quizque/Capstone/stargazer/stargazer.step

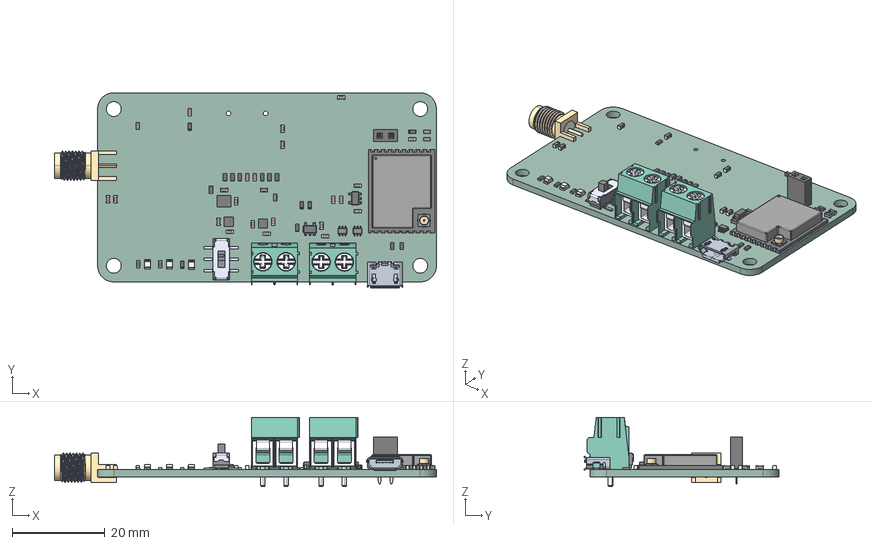
[picture p1: CAD file, 2024-07-02]
stargazer/stargazer.step
82.3 x 42.1 x 14.9 mm
ESP32-C3-WROOM-02U
R_0603_1608Metric x 17
C_0603_1608Metric x 27
JS202011SCQN
LGA_12_2x2mm_P05mm x 2
SOT_23_5 x 2
LGA_14_3x25mm_P05mm_LayoutBorder3x4y
DCK0006A_ASM x 2
PinSocket_1x02_P254mm_Vertical
CON-SMA-EDGE-S
LED_0805_2012Metric x 3
10118193-0001LF
stargazer_PCB
