quizque/Capstone/tools/data_vis/rocket.obj

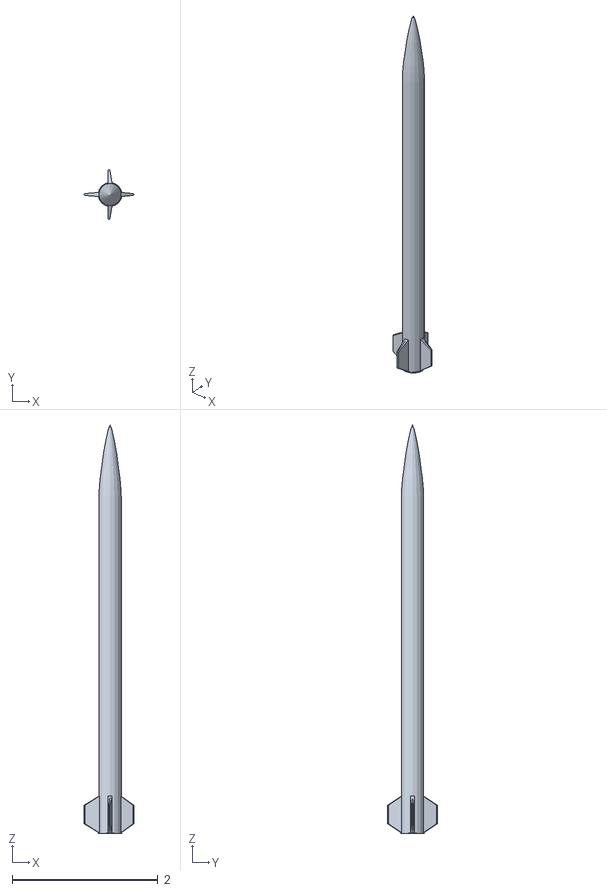
[picture p2: CAD file, 2024-07-23]
tools/data_vis/rocket.obj
0.689 x 0.689 x 5.61
