quizque/Capstone/sensor-testing/attenuation.xlsx

Noise Floor | -80
Nothing | -55
Steel Cube | -60
Aluminum | -65
Carbon | -60
