quizque/Capstone/sensor-testing/Pressure sensor data.xlsx

time | LPS25HBTR | LPS25HBTR (n) | LPS25HBTR (n,f) | time | BMP280 | BMP280 (n) | BMP280 (n,f) | time | MS8607 | BMP390 | MS8607(n) | BMP390 (n) | MS8607(n,f) | BMP390 (n,f)
5.7e-05 | 997.041 | 0.589440277 |  | 0.000973 | 990.4519 | 0.6601269475
0.044008 | 997.1052 | 0.7746682054 |  | 0.043924 | 990.4841 | 0.7530294287 |  | 3.374843 | 991.01001 | 990.442934 | 0.439944 | 1
0.087608 | 997.0659 | 0.6612810156 | 0.6716676284 | 0.08653801 | 990.4389 | 0.6226197346 | 0.6645989613 | 3.458227 | 991.059998 | 990.362652 | 0.639896 | 0.7693867702 | 0.429934 | 0.6346933851
0.131169 | 997.1001 | 0.7599538373 | 0.7389642239 | 0.129095 | 990.4712 | 0.7158107328 | 0.7018176572 | 3.541538 | 991.080017 | 990.317891 | 0.719972 | 0.6408090221 | 0.629946 | 0.7627512036 | STDEV.s
0.17461 | 997.1023 | 0.7663012118 | 0.7384593191 | 0.171532 | 990.4519 | 0.6601269475 | 0.6646710906 | 3.624839 | 991.070007 | 990.297183 | 0.679932 | 0.5813244706 | 0.679933 | 0.6432111834
0.218063 | 997.0972 | 0.7515868436 | 0.7573571841 | 0.213937 | 990.448 | 0.6488747836 | 0.6684218119 | 3.708136 | 991.090027 | 990.291094 | 0.760012 | 0.5638335765 | 0.729982 | 0.5874501614 | LPS25HBTR
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
