quizque/Capstone/stargazer/stargazer.kicad_pcb

## KiCad design stargazer/stargazer.kicad_pcb (2024-07-26)

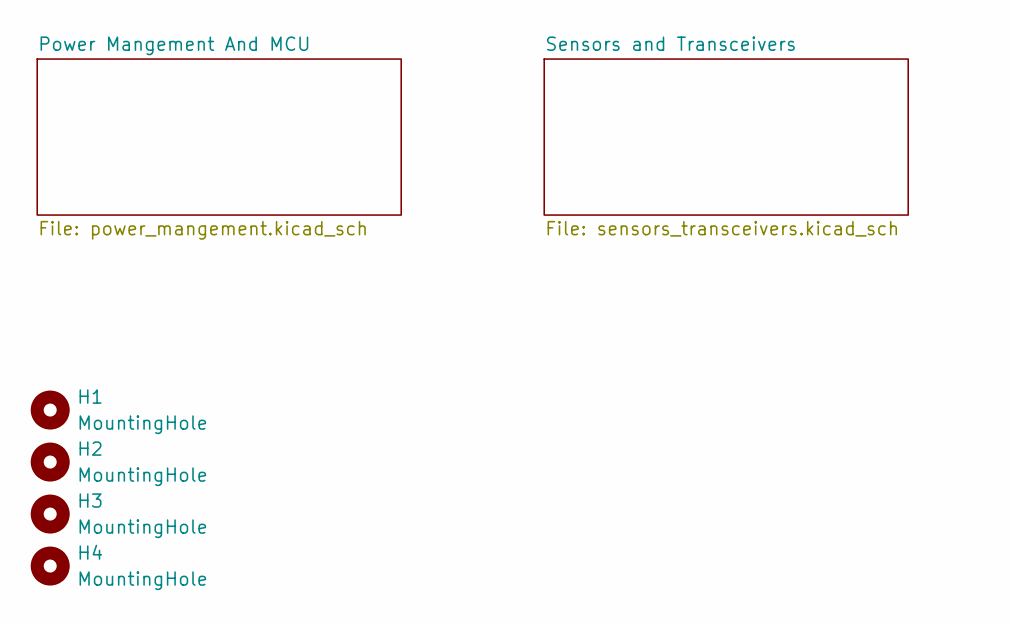
[picture p3: schematic stargazer.kicad_sch]

Parts:
H1, H2, H3, H4: MountingHole; MountingHole_3.2mm_M3_DIN965_Pad

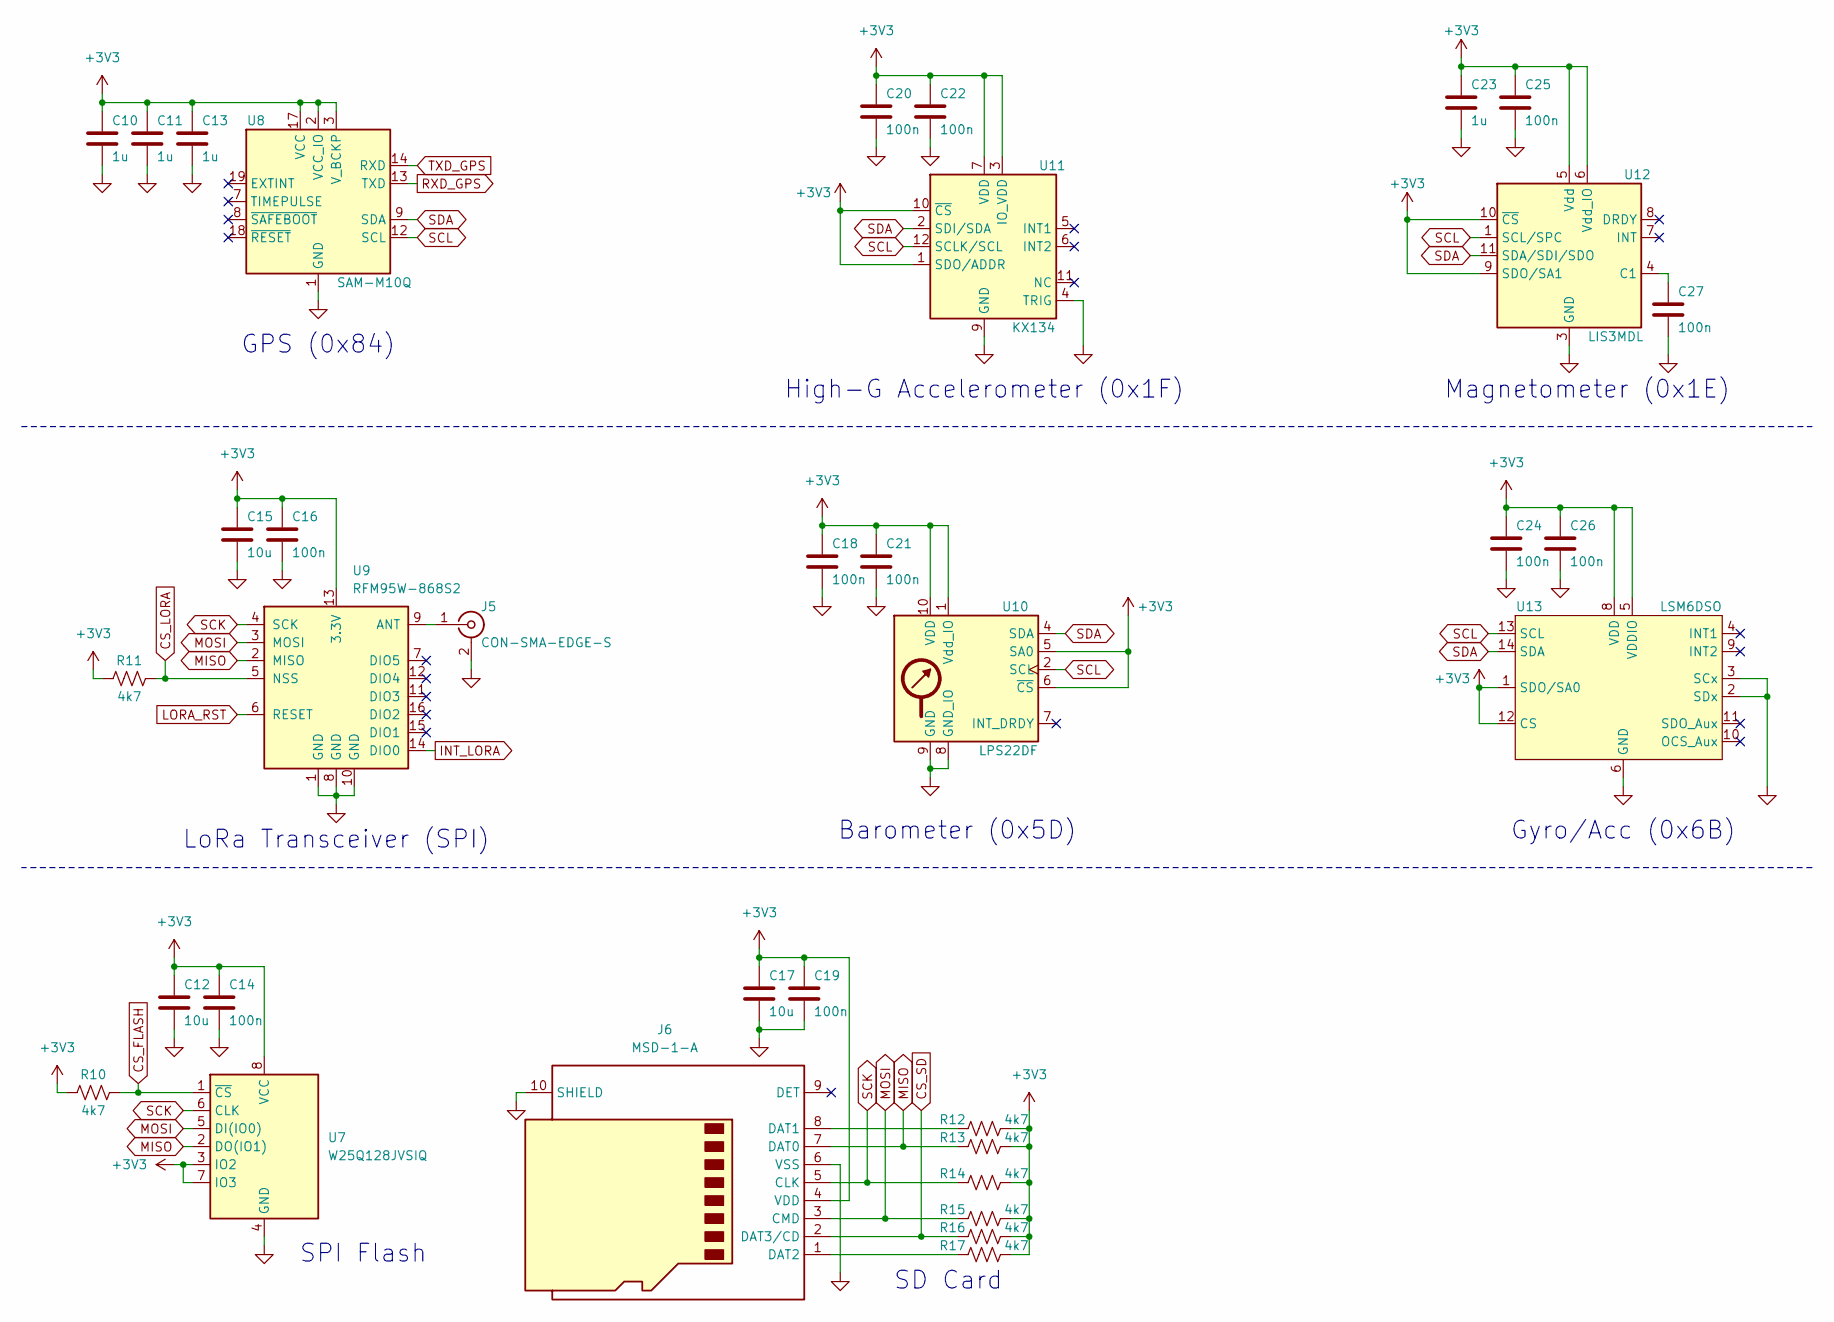
[picture p4: schematic sensors_transceivers.kicad_sch, Sensors & Data ICs]

Parts:
C10, C11, C13, C23: 1u; C_0603_1608Metric; digikeynumber CL10B105KP8NFNC
C12, C15, C17: 10u; C_0603_1608Metric; digikeynumber CL10A106KQ8NNNC
C14, C16, C18, C19, C20, C21, C22, C24, C25, C26, C27: 100n; C_0603_1608Metric; digikeynumber CL10B104KO8NNWC
J5: CON-SMA-EDGE-S; RFSOLUTIONS_CON-SMA-EDGE-S; digikeynumber CON-SMA-EDGE-S
J6: MSD-1-A; CONN9_MSD-1_CUD; digikeynumber MSD-1-A
R10, R11, R12, R13, R14, R15, R16, R17: 4k7; R_0603_1608Metric; digikeynumber RC0603FR-074K7L
U7: W25Q128JVSIQ; SOIC-8_5.23x5.23mm_P1.27mm; digikeynumber W25Q128JVSIQ
U8: SAM-M10Q; ublox_SAM-M10Q; digikeynumber SAM-M10Q-00B
U9: RFM95W-868S2; HOPERF_RFM9XW_SMD
U10: LPS22DF; ST_HLGA-10_2x2mm_P0.5mm_LayoutBorder3x2y; digikeynumber LPS22DFTR
U11: KX134; LGA-12_2x2mm_P0.5mm; digikeynumber KX134-1211
U12: LIS3MDL; LGA-12_2x2mm_P0.5mm; digikeynumber LIS3MDLTR
U13: LSM6DSO; LGA-14_3x2.5mm_P0.5mm_LayoutBorder3x4y; digikeynumber LSM6DSOTR

Connections:
+3V3: C10.1, C11.1, C12.1, C13.1, C14.1, C15.1, C16.1, C17.1, C18.1, C19.1, C20.1, C21.1, C22.1, C23.1, C24.1, C25.1, C26.1, J6.4 (VDD), R10.1, R11.1, R12.2, R13.2, R14.2, R15.2, R16.2, R17.2, U7.3 (IO2), U7.7 (IO3), U7.8 (VCC), U8.2 (VCC_IO), U8.3 (V_BCKP), U8.17 (VCC), U9.13 (3.3V), U10.1 (Vdd_IO), U10.5 (SA0), U10.6 (~CS), U10.10 (VDD), U11.1 (SDO/ADDR), U11.3 (IO_VDD), U11.7 (VDD), U11.10 (~CS), U12.5 (Vdd), U12.6 (Vdd_IO), U12.9 (SDO/SA1), U12.10 (~CS), U13.1 (SDO/SA0), U13.5 (VDDIO), U13.8 (VDD), U13.12 (CS); also elsewhere on the board
CS_FLASH: R10.2, U7.1 (~CS); also elsewhere on the board
CS_LORA: R11.2, U9.5 (NSS); also elsewhere on the board
CS_SD: J6.2 (DAT3/CD), R16.1; also elsewhere on the board
GND: C10.2, C11.2, C12.2, C13.2, C14.2, C15.2, C16.2, C17.2, C18.2, C19.2, C20.2, C21.2, C22.2, C23.2, C24.2, C25.2, C26.2, C27.2, J5.2 (Ext), J6.6 (VSS), J6.10 (SHIELD), U7.4 (GND), U8.1 (GND), U8.4 (GND), U8.5 (GND), U8.6 (GND), U8.10 (GND), U8.11 (GND), U8.15 (GND), U8.16 (GND), U8.20 (GND), U9.1 (GND), U9.8 (GND), U9.10 (GND), U10.3 (GND), U10.8 (GND_IO), U10.9 (GND), U11.4 (TRIG), U11.8 (GND), U11.9 (GND), U12.2 (GND), U12.3 (GND), U12.12 (GND), U13.2 (SDx), U13.3 (SCx), U13.6 (GND), U13.7 (GND); also elsewhere on the board
INT_LORA: U9.14 (DIO0); also elsewhere on the board
LORA_RST: U9.6 (RESET); also elsewhere on the board
MISO: J6.7 (DAT0), R13.1, U7.2 (DO(IO1)), U9.2 (MISO); also elsewhere on the board
MOSI: J6.3 (CMD), R15.1, U7.5 (DI(IO0)), U9.3 (MOSI); also elsewhere on the board
unnamed: J5.1 (In), U9.9 (ANT)
unnamed: J6.8 (DAT1), R12.1
unnamed: J6.1 (DAT2), R17.1
unnamed: C27.1, U12.4 (C1)
RXD_GPS: U8.13 (TXD); also elsewhere on the board
SCK: J6.5 (CLK), R14.1, U7.6 (CLK), U9.4 (SCK); also elsewhere on the board
SCL: U8.12 (SCL), U10.2 (SCL), U11.12 (SCLK/SCL), U12.1 (SCL/SPC), U13.13 (SCL); also elsewhere on the board
SDA: U8.9 (SDA), U10.4 (SDA), U11.2 (SDI/SDA), U12.11 (SDA/SDI/SDO), U13.14 (SDA); also elsewhere on the board
TXD_GPS: U8.14 (RXD); also elsewhere on the board

Notes on the sheet:
Magnetometer (0x1E)
GPS (0x84)
High-G Accelerometer (0x1F)
SD Card
Gyro/Acc (0x6B)
LoRa Transceiver (SPI)
SPI Flash
Barometer (0x5D)

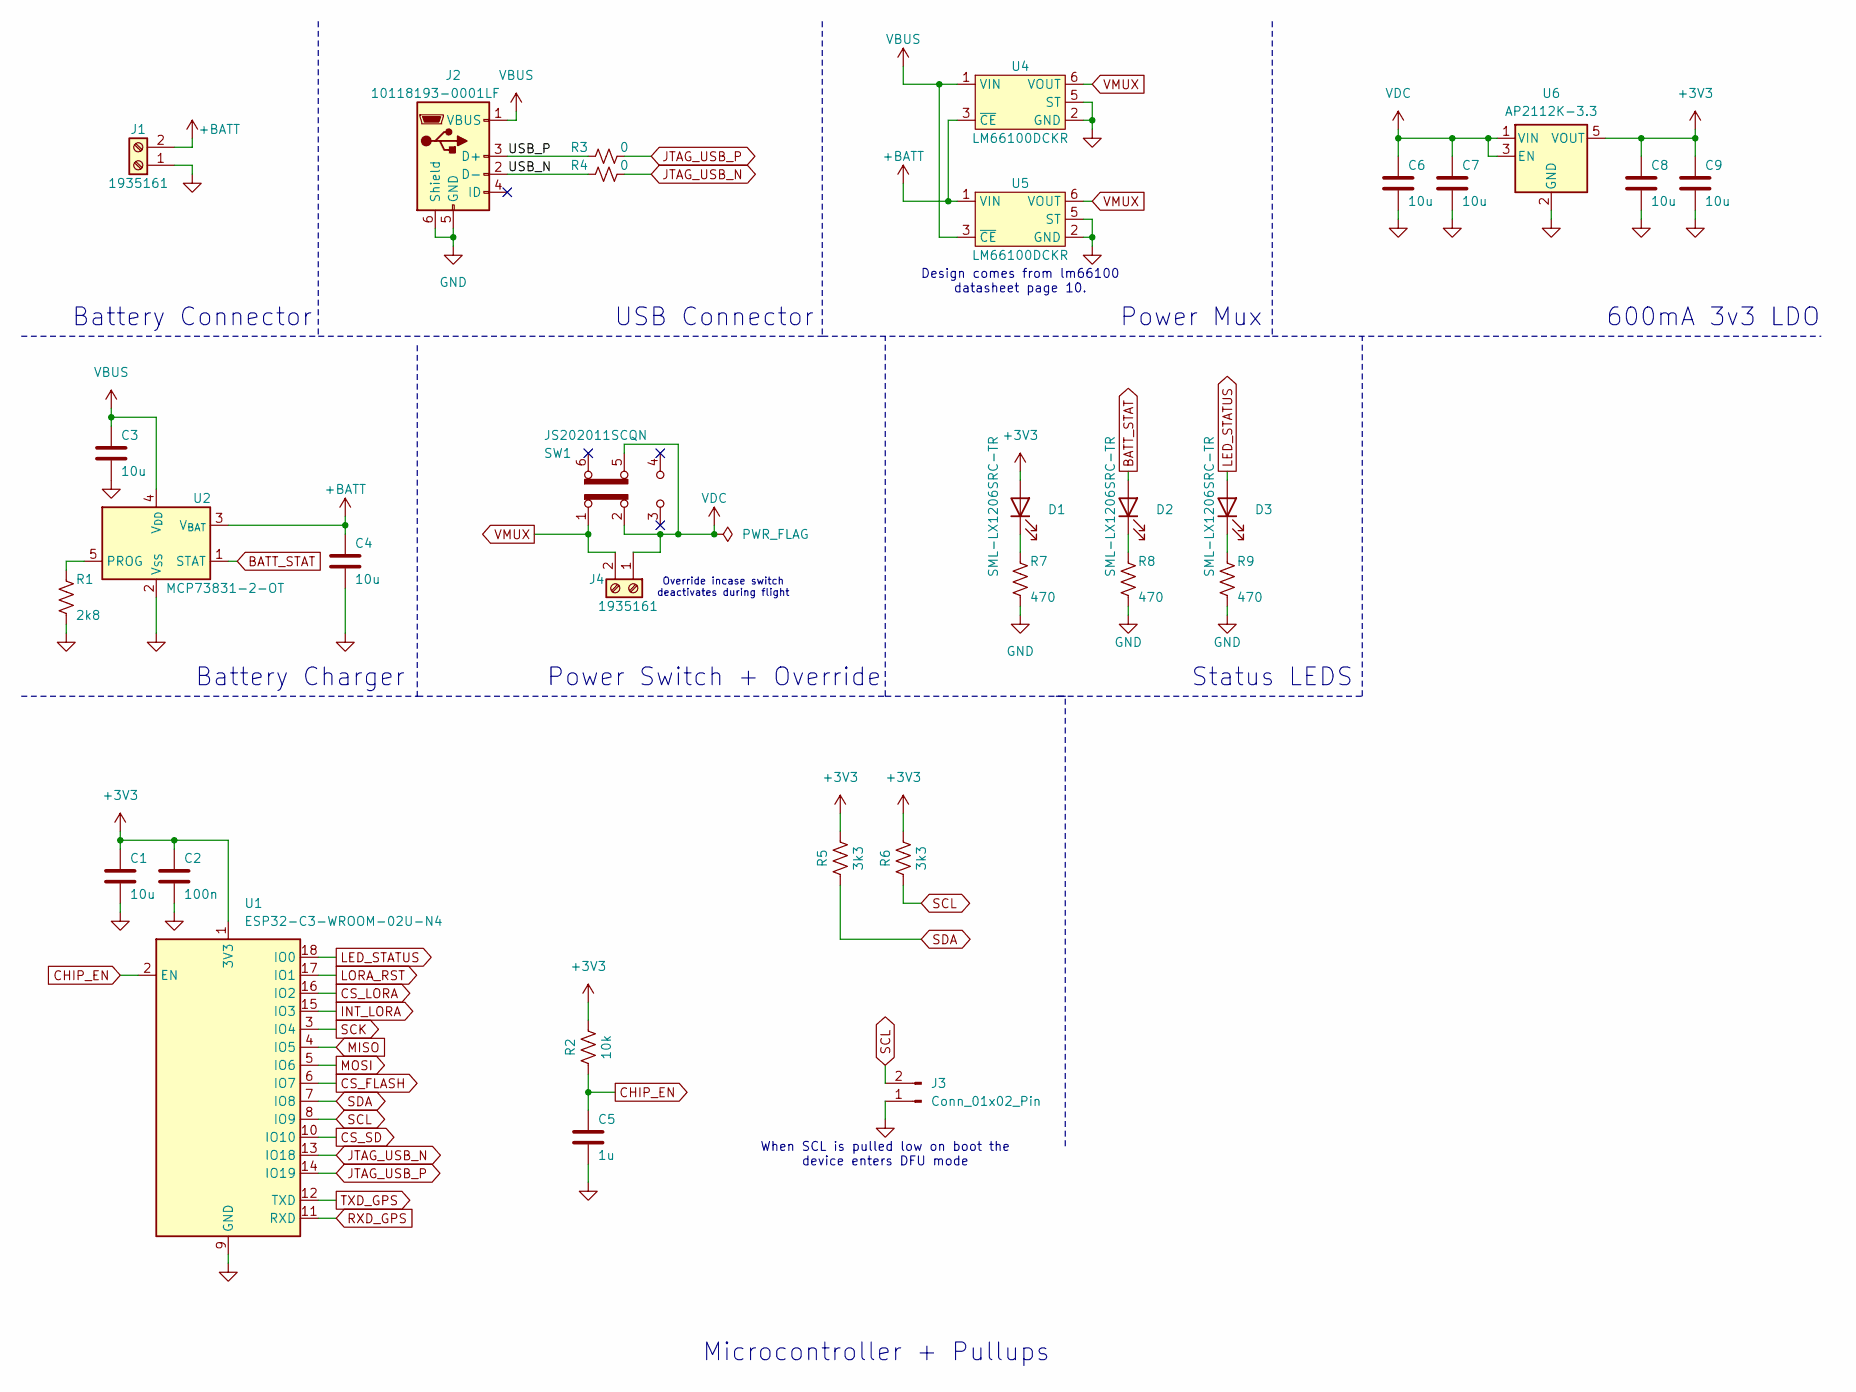
[picture p5: schematic power_mangement.kicad_sch, Power & Microcontroller]

Parts:
C1, C3, C4, C6, C7, C8, C9: 10u; C_0603_1608Metric; digikeynumber CL10A106KQ8NNNC
C2: 100n; C_0603_1608Metric; digikeynumber CL10B104KO8NNWC
C5: 1u; C_0603_1608Metric; digikeynumber CL10B105KP8NFNC
D1, D2, D3: SML-LX1206SRC-TR; LED_0805_2012Metric; digikeynumber SML-LX1206SRC-TR
J1, J4: 1935161; PHOENIX_1935161; digikeynumber 1935161
J2: 10118193-0001LF; AMPHENOL_10118193-0001LF; digikeynumber 10118193-0001LF
J3: Conn_01x02_Pin; PinSocket_1x02_P2.54mm_Vertical
R1: 2k8; R_0603_1608Metric; digikeynumber RC0603DR-072K8L
R2: 10k; R_0603_1608Metric; digikeynumber RC0603DR-0710KL
R3, R4: 0; R_0603_1608Metric; digikeynumber RC0603FR-130RL
R5, R6: 3k3; R_0603_1608Metric; digikeynumber RC0603FR-103K3L
R7, R8, R9: 470; R_0603_1608Metric; digikeynumber RC0603FR-13470RL
SW1: JS202011SCQN; SW_JS202011SCQN; digikeynumber JS202011SCQN
U1: ESP32-C3-WROOM-02U-N4; ESP32-C3-WROOM-02U; digikeynumber ESP32-C3-WROOM-02U-N4
U2: MCP73831-2-OT; SOT-23-5; digikeynumber MCP73831T-2ACI/OT
U4, U5: LM66100DCKR; DCK6_TEX; digikeynumber LM66100DCKR
U6: AP2112K-3.3; SOT-23-5; digikeynumber AP2112K-3.3TRG1

Connections:
+3V3: C1.1, C2.1, C8.1, C9.1, D1.2 (A), R2.2, R5.2, R6.2, U1.1 (3V3), U6.5 (VOUT); also elsewhere on the board
+BATT: C4.1, J1.2, U2.3 (V_{BAT}), U4.3 (~CE), U5.1 (VIN)
/Power Mangement And MCU/USB_N: J2.2 (D-), R4.1
/Power Mangement And MCU/USB_P: J2.3 (D+), R3.1
BATT_STAT: D2.2 (A), U2.1 (STAT)
CHIP_EN: C5.1, R2.1, U1.2 (EN)
CS_FLASH: U1.6 (IO7); also elsewhere on the board
CS_LORA: U1.16 (IO2); also elsewhere on the board
CS_SD: U1.10 (IO10); also elsewhere on the board
GND: C1.2, C2.2, C3.2, C4.2, C5.2, C6.2, C7.2, C8.2, C9.2, J1.1, J2.5 (GND), J2.6 (Shield), J3.1, R1.2, R7.2, R8.2, R9.2, U1.9 (GND), U1.19 (GND), U2.2 (V_{SS}), U4.2 (GND), U4.5 (ST), U5.2 (GND), U5.5 (ST), U6.2 (GND); also elsewhere on the board
INT_LORA: U1.15 (IO3); also elsewhere on the board
JTAG_USB_N: R4.2, U1.13 (IO18)
JTAG_USB_P: R3.2, U1.14 (IO19)
LED_STATUS: D3.2 (A), U1.18 (IO0)
LORA_RST: U1.17 (IO1); also elsewhere on the board
MISO: U1.4 (IO5); also elsewhere on the board
MOSI: U1.5 (IO6); also elsewhere on the board
unnamed: D1.1 (K), R7.1
unnamed: D2.1 (K), R8.1
unnamed: D3.1 (K), R9.1
unnamed: R1.1, U2.5 (PROG)
RXD_GPS: U1.11 (RXD); also elsewhere on the board
SCK: U1.3 (IO4); also elsewhere on the board
SCL: J3.2, R6.1, U1.8 (IO9); also elsewhere on the board
SDA: R5.1, U1.7 (IO8); also elsewhere on the board
TXD_GPS: U1.12 (TXD); also elsewhere on the board
VBUS: C3.1, J2.1 (VBUS), U2.4 (V_{DD}), U4.1 (VIN), U5.3 (~CE)
VDC: C6.1, C7.1, J4.1, SW1.2 (B), SW1.5 (B), U6.1 (VIN), U6.3 (EN)
VMUX: J4.2, SW1.1 (A), U4.6 (VOUT), U5.6 (VOUT)

Notes on the sheet:
600mA 3v3 LDO
USB Connector
Battery Charger
Power Switch + Override
Design comes from lm66100 datasheet page 10.
Power Mux
When SCL is pulled low on boot the device enters DFU mode
Status LEDS
Override incase switch deactivates during flight
Microcontroller + Pullups
Battery Connector

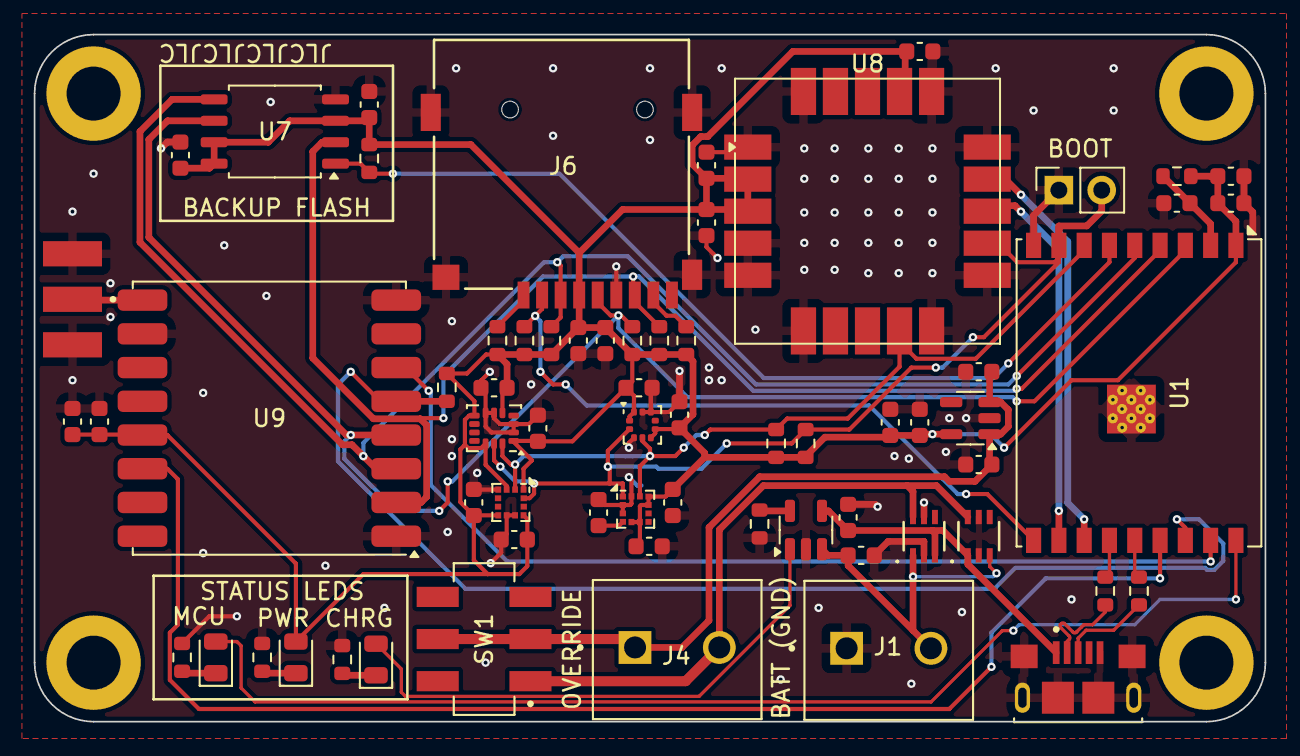
[picture p6: board stargazer.kicad_pcb from above]

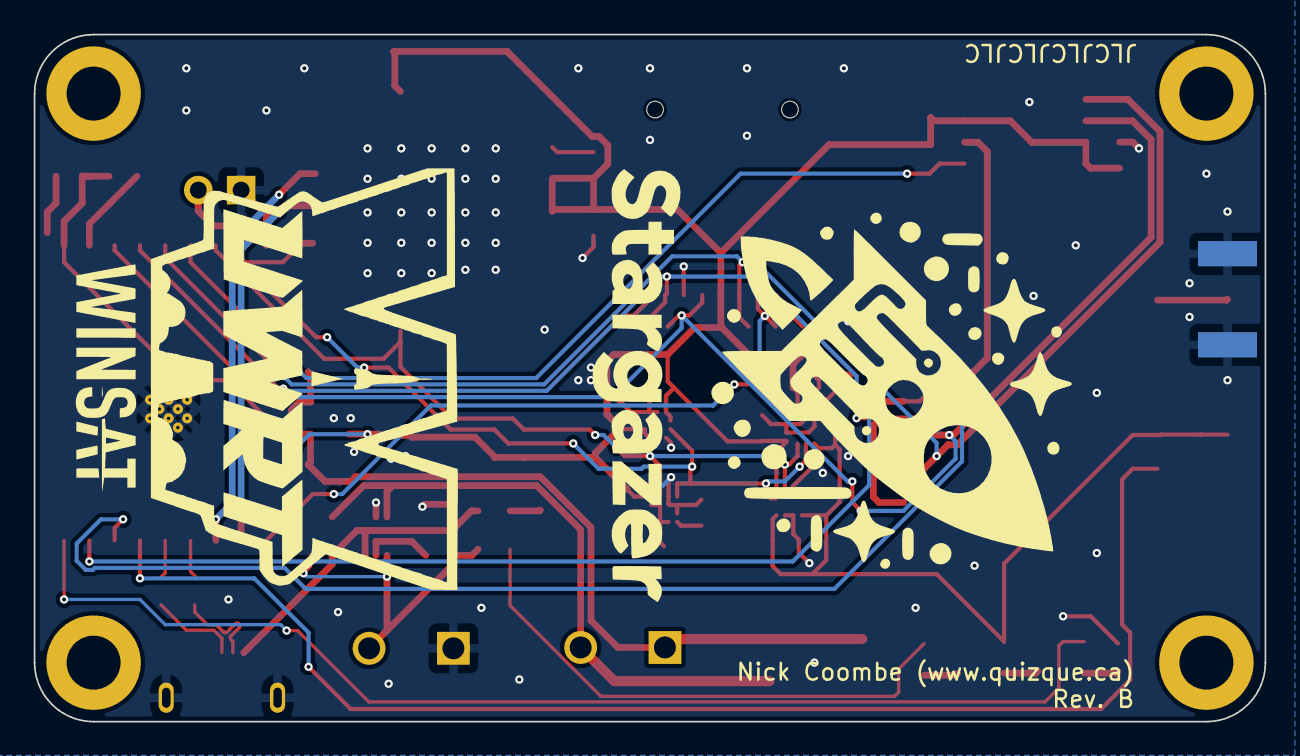
[picture p7: board stargazer.kicad_pcb from below]

Board: 2 copper layers, 73.0 x 40.8 mm, 72 parts (2 on the bottom side), 33 nets.

Other parts of the board:
logo: LOGO
winsatlogo: LOGO
