quizque/Capstone/Misc/stargazer/microcontroller.kicad_sch

## KiCad design Misc/stargazer/microcontroller.kicad_sch (2024-05-11)

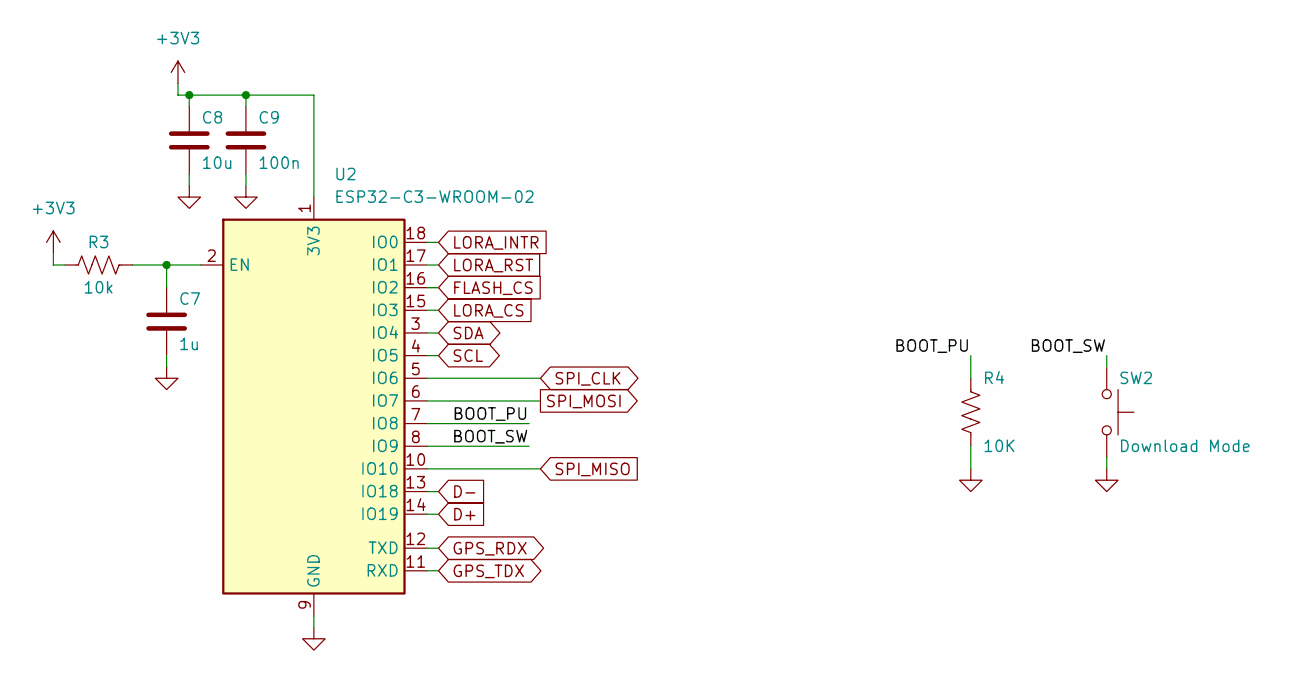
[picture p8: schematic microcontroller.kicad_sch]

Parts:
C7: 1u; C_0201_0603Metric
C8: 10u; C_0201_0603Metric
C9: 100n; C_0201_0603Metric
R3: 10k
R4: 10K
SW2: Download Mode
U2: ESP32-C3-WROOM-02

Connections:
+3V3: C8.1, C9.1, R3.1, U2.1 (3V3)
BOOT_PU: R4.1, U2.7 (IO8)
BOOT_SW: SW2.1, U2.8 (IO9)
D+: U2.14 (IO19)
D-: U2.13 (IO18)
FLASH_CS: U2.16 (IO2)
GND: C7.2, C8.2, C9.2, R4.2, SW2.2, U2.9 (GND), U2.19 (GND)
GPS_RDX: U2.12 (TXD)
GPS_TDX: U2.11 (RXD)
LORA_CS: U2.15 (IO3)
LORA_INTR: U2.18 (IO0)
LORA_RST: U2.17 (IO1)
unnamed: C7.1, R3.2, U2.2 (EN)
SCL: U2.4 (IO5)
SDA: U2.3 (IO4)
SPI_CLK: U2.5 (IO6)
SPI_MISO: U2.10 (IO10)
SPI_MOSI: U2.6 (IO7)
