quizque/Capstone/Misc/stargazer/sensors_transceivers.kicad_sch

## KiCad design Misc/stargazer/sensors_transceivers.kicad_sch (2024-05-11)

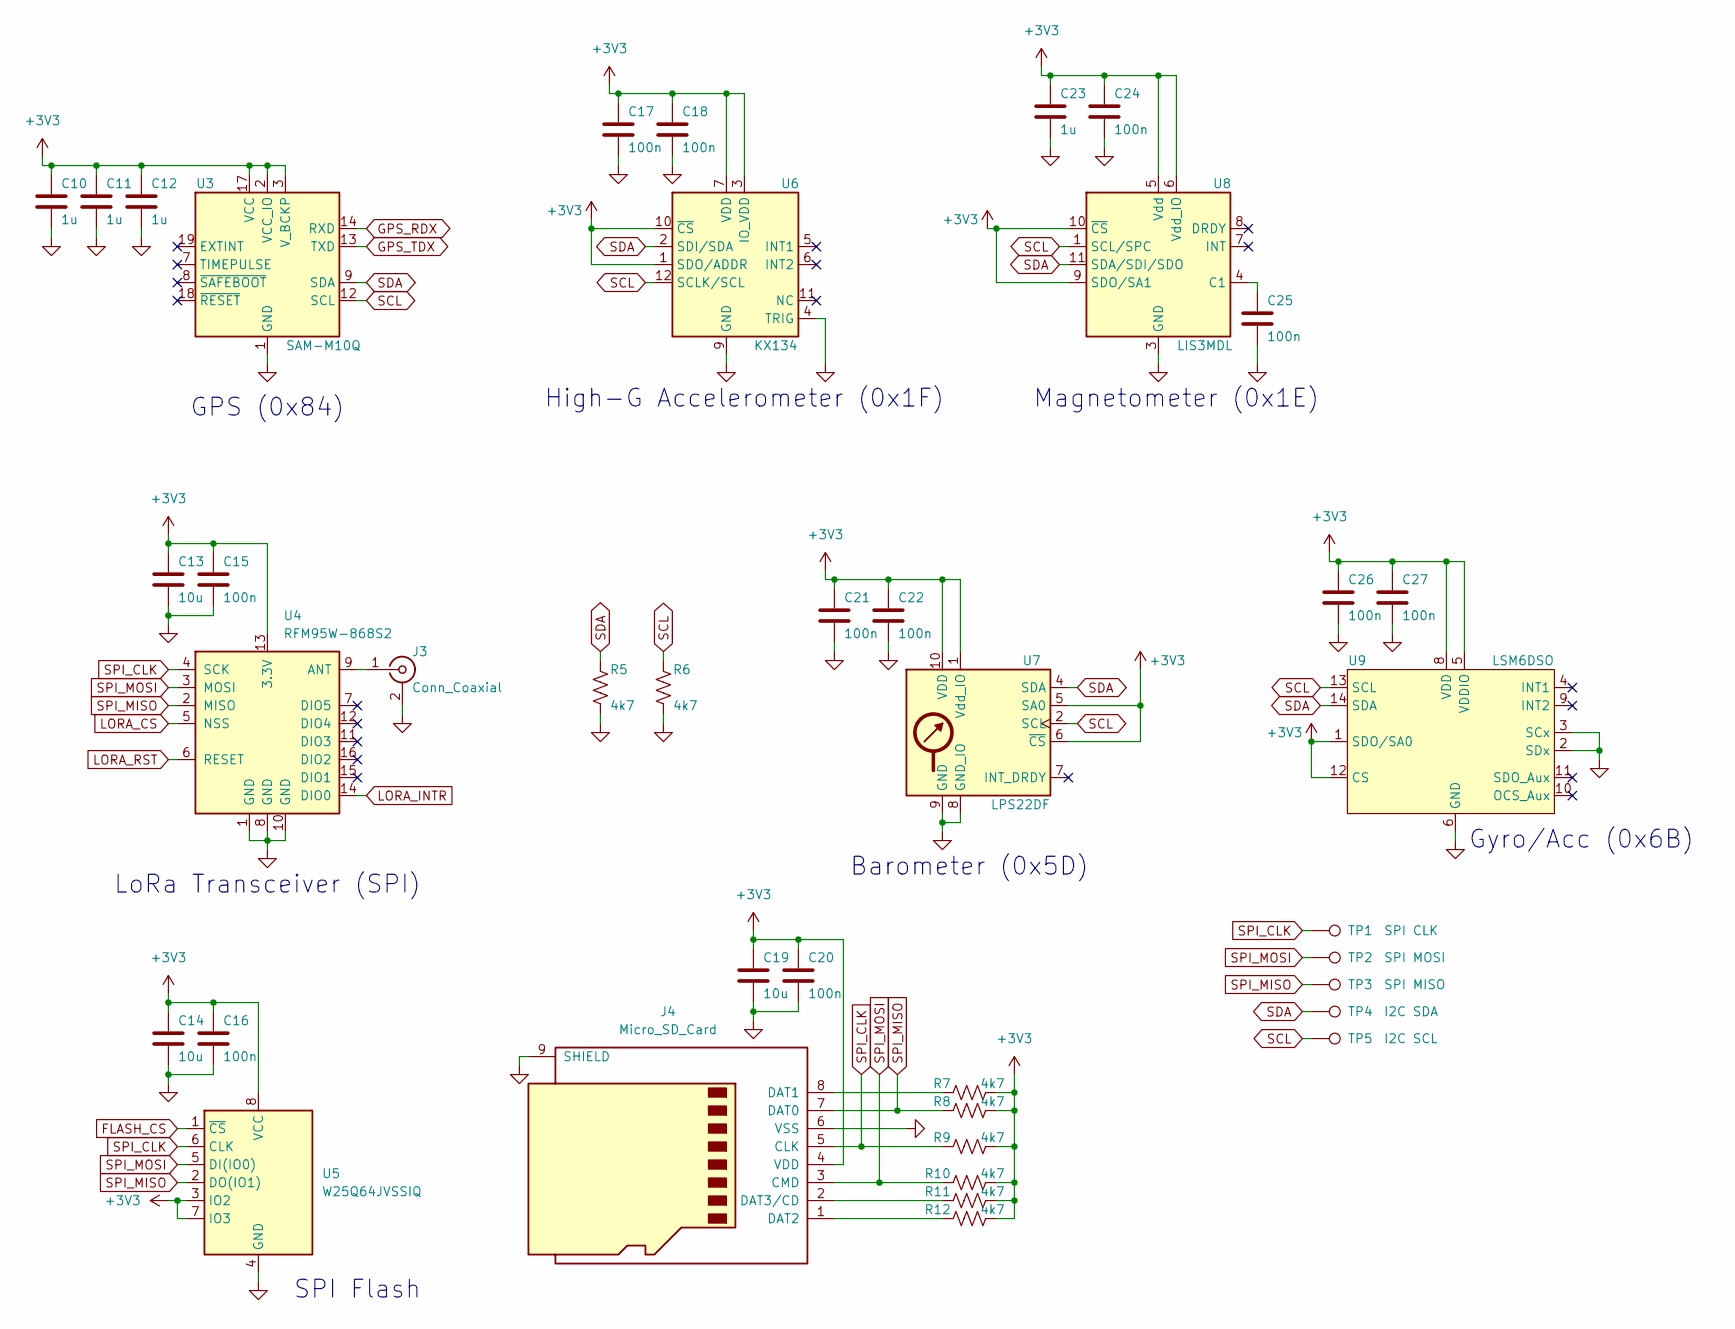
[picture p9: schematic sensors_transceivers.kicad_sch]

Parts:
C10, C11, C12, C23: 1u; C_0201_0603Metric
C13, C14, C19: 10u; C_0201_0603Metric
C15, C16, C17, C18, C20, C21, C22, C24, C25, C26, C27: 100n; C_0201_0603Metric
J3: Conn_Coaxial
J4: Micro_SD_Card
R5, R6, R7, R8, R9, R10, R11, R12: 4k7
TP1: SPI CLK; TestPoint_Pad_1.0x1.0mm
TP2: SPI MOSI; TestPoint_Pad_1.0x1.0mm
TP3: SPI MISO; TestPoint_Pad_1.0x1.0mm
TP4: I2C SDA; TestPoint_Pad_1.0x1.0mm
TP5: I2C SCL; TestPoint_Pad_1.0x1.0mm
U3: SAM-M10Q
U4: RFM95W-868S2
U5: W25Q64JVSSIQ
U6: KX134
U7: LPS22DF; ST_HLGA-10_2x2mm_P0.5mm_LayoutBorder3x2y
U8: LIS3MDL; LGA-12_2x2mm_P0.5mm
U9: LSM6DSO

Connections:
+3V3: C10.1, C11.1, C12.1, C13.1, C14.1, C15.1, C16.1, C17.1, C18.1, C19.1, C20.1, C21.1, C22.1, C23.1, C24.1, C26.1, C27.1, J4.4 (VDD), R7.2, R8.2, R9.2, R10.2, R11.2, R12.2, U3.2 (VCC_IO), U3.3 (V_BCKP), U3.17 (VCC), U4.13 (3.3V), U5.3 (IO2), U5.7 (IO3), U5.8 (VCC), U6.1 (SDO/ADDR), U6.3 (IO_VDD), U6.7 (VDD), U6.10 (~CS), U7.1 (Vdd_IO), U7.5 (SA0), U7.6 (~CS), U7.10 (VDD), U8.5 (Vdd), U8.6 (Vdd_IO), U8.9 (SDO/SA1), U8.10 (~CS), U9.1 (SDO/SA0), U9.5 (VDDIO), U9.8 (VDD), U9.12 (CS)
FLASH_CS: U5.1 (~CS)
GND: C10.2, C11.2, C12.2, C13.2, C14.2, C15.2, C16.2, C17.2, C18.2, C19.2, C20.2, C21.2, C22.2, C23.2, C24.2, C25.2, C26.2, C27.2, J3.2 (Ext), J4.6 (VSS), J4.9 (SHIELD), R5.2, R6.2, U3.1 (GND), U3.4 (GND), U3.5 (GND), U3.6 (GND), U3.10 (GND), U3.11 (GND), U3.15 (GND), U3.16 (GND), U3.20 (GND), U4.1 (GND), U4.8 (GND), U4.10 (GND), U5.4 (GND), U6.4 (TRIG), U6.8 (GND), U6.9 (GND), U7.3 (GND), U7.8 (GND_IO), U7.9 (GND), U8.2 (GND), U8.3 (GND), U8.12 (GND), U9.2 (SDx), U9.3 (SCx), U9.6 (GND), U9.7 (GND)
GPS_RDX: U3.14 (RXD)
GPS_TDX: U3.13 (TXD)
LORA_CS: U4.5 (NSS)
LORA_INTR: U4.14 (DIO0)
LORA_RST: U4.6 (RESET)
unnamed: C25.1, U8.4 (C1)
unnamed: J3.1 (In), U4.9 (ANT)
unnamed: J4.1 (DAT2), R12.1
unnamed: J4.2 (DAT3/CD), R11.1
unnamed: J4.8 (DAT1), R7.1
SCL: R6.1, TP5.1, U3.12 (SCL), U6.12 (SCLK/SCL), U7.2 (SCL), U8.1 (SCL/SPC), U9.13 (SCL)
SDA: R5.1, TP4.1, U3.9 (SDA), U6.2 (SDI/SDA), U7.4 (SDA), U8.11 (SDA/SDI/SDO), U9.14 (SDA)
SPI_CLK: J4.5 (CLK), R9.1, TP1.1, U4.4 (SCK), U5.6 (CLK)
SPI_MISO: J4.7 (DAT0), R8.1, TP3.1, U4.2 (MISO), U5.2 (DO(IO1))
SPI_MOSI: J4.3 (CMD), R10.1, TP2.1, U4.3 (MOSI), U5.5 (DI(IO0))

Notes on the sheet:
Magnetometer (0x1E)
GPS (0x84)
High-G Accelerometer (0x1F)
Gyro/Acc (0x6B)
LoRa Transceiver (SPI)
SPI Flash
Barometer (0x5D)
