quizque/Capstone/stargazer-src/include/stargazer_constants.h

// IO pin definitions for the Stargazer board
#define LED_STATUS 0
#define LORA_RST 1
#define LORA_CS 2
#define LORA_IRQ 3
#define SCK 4
#define MISO 5
#define MOSI 6
#define FLASH_CS 7
#define I2C_SDA 8
#define I2C_SCL 9
#define SD_CS 10
