quizque/Capstone/tools/data_vis/3dmodel.py

# Connects to the data server and displays the quaternion direction
# as the model of a 3D rocket. PuGame is not designed for OpenGL
# applications, so this program acts a little weird some times

from queue import Queue
import threading
import numpy as np
from pygame.locals import *
from OpenGL.GL import *
from OpenGL.GLU import *
import pygame
import socket
import struct

# Thread safe queue
serial_data_queue = Queue()


# Network configuration
host = "localhost"
port = 12345

# Create a socket object
sock = socket.socket(socket.AF_INET, socket.SOCK_STREAM)

# Connect to the server
sock.connect((host, port))


def network_thread():
    try:
        while True:
            # Receive data from the server
            data_bytes = sock.recv(36)
            data = struct.unpack("fffffffff", data_bytes)

            # Parse the quaternion
            q = list(data[0:4])
            print(q)

            # Push it onto the queue
            serial_data_queue.put(q)

            # Remove any extra data off the queue
            if serial_data_queue.qsize() > 1:
                serial_data_queue.get()

    except KeyboardInterrupt:
        print("Exiting...")

    finally:
        sock.close()


# Convert a quaternion to a rotation matrix
# This has been modified to work with OpenGL
# and numpy, so it contains an extra row
def quaternion_to_rotation_matrix(q):
    q0, q1, q2, q3 = q
    R = np.array(
        [
            [
                1 - 2 * (q2**2 + q3**2),
                2 * (q1 * q2 - q0 * q3),
                2 * (q1 * q3 + q0 * q2),
                0,
            ],
            [
                2 * (q1 * q2 + q0 * q3),
                1 - 2 * (q1**2 + q3**2),
                2 * (q2 * q3 - q0 * q1),
                0,
            ],
            [
                2 * (q1 * q3 - q0 * q2),
                2 * (q2 * q3 + q0 * q1),
                1 - 2 * (q1**2 + q2**2),
                0,
            ],
            [0, 0, 0, 1],  # Add an extra row for a 4x4 matrix
        ]
    )
    return R


# Function to load an OBJ file
# https://medium.com/@harunijaz/the-code-above-is-a-python-function-that-reads-and-loads-data-from-a-obj-e6f6e5c3dfb9
def load_obj(filename):
    vertices = []
    faces = []
    texcoords = []
    texcoord_indices = []
    with open(filename) as f:
        for line in f:
            if line.startswith("v "):
                vertices.append(list(map(float, line.strip().split()[1:])))
            elif line.startswith("vt "):
                texcoords.append(list(map(float, line.strip().split()[1:])))
            elif line.startswith("f "):
                face = []
                tex_index = []
                for vertex in line.strip().split()[1:]:
                    v, t, _ = vertex.split("/")
                    face.append(int(v) - 1)
                    tex_index.append(int(t) - 1)
                faces.append(face)
                texcoord_indices.append(tex_index)
    return (
        np.array(vertices, dtype=np.float32),
        np.array(faces, dtype=np.int32),
        np.array(texcoords, dtype=np.float32),
        np.array(texcoord_indices, dtype=np.int32),
    )


# Function to load the texture
def load_texture(filename):
    texture_surface = pygame.image.load(filename)
    # Convert pygame image to opengl texture
    texture_data = pygame.image.tostring(texture_surface, "RGB", 1)
    width, height = texture_surface.get_rect().size
    glEnable(GL_TEXTURE_2D)
    texture_id = glGenTextures(1)
    glBindTexture(GL_TEXTURE_2D, texture_id)
    glTexImage2D(
        GL_TEXTURE_2D,
        0,
        GL_RGB,
        width,
        height,
        0,
        GL_RGB,
        GL_UNSIGNED_BYTE,
        texture_data,
    )
    glTexParameterf(GL_TEXTURE_2D, GL_TEXTURE_MIN_FILTER, GL_LINEAR)
    glTexParameterf(GL_TEXTURE_2D, GL_TEXTURE_MAG_FILTER, GL_LINEAR)
    glTexParameterf(GL_TEXTURE_2D, GL_TEXTURE_WRAP_S, GL_REPEAT)
    glTexParameterf(GL_TEXTURE_2D, GL_TEXTURE_WRAP_T, GL_REPEAT)
    return texture_id


# Function to draw the loaded model with texture
def draw_model(vertices, faces, texcoords, texcoord_indices, texture_id):
    glEnable(GL_TEXTURE_2D)
    # Set texture, does not obey any UV maps
    glBindTexture(GL_TEXTURE_2D, texture_id)
    glBegin(GL_TRIANGLES)
    # Draws each vertex individually, there should be faster way
    for i, face in enumerate(faces):
        for j, vertex in enumerate(face):
            glTexCoord2fv(texcoords[texcoord_indices[i][j]])
            glVertex3fv(vertices[vertex])
    glEnd()
    glDisable(GL_TEXTURE_2D)


def main():

    # Initialize Pygame
    pygame.init()
    display = (600, 600)
    screen = pygame.display.set_mode(display, DOUBLEBUF | OPENGLBLIT)
    hidden_screen = pygame.Surface(display, flags=pygame.SRCALPHA)
    gluPerspective(45, (display[0] / display[1]), 0.1, 50.0)
    glTranslatef(0.0, 0.0, -5)

    vertices, faces, texcoords, texcoord_indices = load_obj("rocket.obj")
    global texture_id

    # Texture obtained from texture haven
    texture_id = load_texture("rusty_metal_sheet_diff_1k.jpg")

    clock = pygame.time.Clock()

    # Hold the last rotation (helps with a visual bug)
    last_rot = None

    # Have we obtain data yet?
    r_dat = False

    # Main loop
    while True:
        for event in pygame.event.get():
            if event.type == pygame.QUIT:
                pygame.quit()
                return

        # If we have new data
        if not serial_data_queue.empty():
            # Read it, clear the screen buffer, and get ready to draw it
            serial_data = serial_data_queue.get()
            glClear(GL_COLOR_BUFFER_BIT | GL_DEPTH_BUFFER_BIT)
            quaternion = serial_data_queue.get()
            last_rot = quaternion_to_rotation_matrix(quaternion)
            r_dat = True

        # Clear the screen, again (weird bug)
        glClear(GL_COLOR_BUFFER_BIT | GL_DEPTH_BUFFER_BIT)

        # If we have data
        if r_dat:
            # Apply the rotation matrix
            glLoadIdentity()
            gluPerspective(90, (display[0] / display[1]), 0.1, 50.0)
            glScalef(0.1, 0.1, 0.1)
            glTranslatef(0.0, 0.0, -5)
            # Convert the numpy array to a list and flatten it
            glRotate(-90, 1, 0, 0)
            glMultMatrixf(np.linalg.inv(last_rot).T.flatten().tolist())

            # Draw the model at the rotated matrix
            draw_model(vertices, faces, texcoords, texcoord_indices, texture_id)

        # Flip buffer
        pygame.display.flip()

        # Run at 60 FPS
        clock.tick(60)


if __name__ == "__main__":

    # Start networking thread as daemon (will exit on main exit)
    network_thread = threading.Thread(target=network_thread)
    network_thread.daemon = True
    network_thread.start()

    # Start main
    main()
