quizque/Capstone/(commit log)

2024-02-12 Added asteroid (transmitter)
    [asteroid.kicad_pcb, asteroid.kicad_sch]
2024-03-05 Added SX1262 module stuff
    [SX1262_module.kicad_pcb, SX1262_module.kicad_sch]
2024-03-19 Updated Comet
    [Comet-Unit.kicad_pcb, Comet-Unit.kicad_sch, asteroid.kicad_pcb, asteroid.kicad_sch]
2024-04-03 Added stargazer
    [stargazer.kicad_pcb, stargazer.kicad_sch]
2024-04-05 Added more sensors
    [stargazer.kicad_sch]
2024-04-09 Almost done stargazer
    [stargazer.kicad_sch]
2024-05-11 Moved to misc
    [Comet-Unit.kicad_sch, Pressure sensor data.xlsx, SX1262_module.kicad_pcb, SX1262_module.kicad_sch, attenuation.xlsx, microcontroller.kicad_sch, power_mangement.kicad_sch, sensors_transceivers.kicad_sch]
2024-05-12 New Layout
    [microcontroller.kicad_sch, power_mangement.kicad_sch, sensors_transceivers.kicad_sch, stargazer.kicad_pcb, stargazer.kicad_sch, usb_port.kicad_sch]
2024-05-15 Revision 1
    [power_mangement.kicad_sch, sensors_transceivers.kicad_sch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]
2024-05-15 Cleaned files
    [stargazer-B_Cu.gbr, stargazer-B_Mask.gbr, stargazer-B_Paste.gbr, stargazer-B_Silkscreen.gbr, stargazer-Edge_Cuts.gbr, stargazer-F_Cu.gbr, stargazer-F_Mask.gbr, stargazer-F_Paste.gbr]
2024-05-23 Board Rev B WIP
    [power_mangement.kicad_sch, sensors_transceivers.kicad_sch, stargazer.kicad_pcb, stargazer.kicad_sch]
2024-05-23 Working GPS + UART USB
2024-05-23 Rev B schem finished
    [power_mangement.kicad_sch, sensors_transceivers.kicad_sch]
2024-05-24 Revision B
    [power_mangement.kicad_sch, sensors_transceivers.kicad_sch, stargazer.kicad_pcb]
2024-05-24 calibrated mag
2024-06-04 Working device tester
2024-06-27 Switch to USLetter paper for printing
    [power_mangement.kicad_sch, sensors_transceivers.kicad_sch, stargazer.kicad_sch]
2024-07-23 Added visualisers
    [rocket.obj]
2024-07-26 Stargazer PCB print update
    [power_mangement.kicad_sch, sensors_transceivers.kicad_sch, stargazer.kicad_pcb]
2024-07-28 Renamed demo code
    [rocket.obj]
2024-07-29 Repo cleanup
    [Pressure sensor data.xlsx, SX1262_module.kicad_pcb, SX1262_module.kicad_sch, attenuation.xlsx, rocket.obj]
2024-07-31 Added vibration bay firmware
    [FinalAccel.ino, FinalAccel_WithFLASH.ino]
2024-07-31 Cleaned repo and added rocket model
    [Pressure sensor data.xlsx, SX1262_module.kicad_pcb, SX1262_module.kicad_sch, attenuation.xlsx]
